r8d8/uaefi/boards/uaefi-f3/frame/efi-schematic.pdf

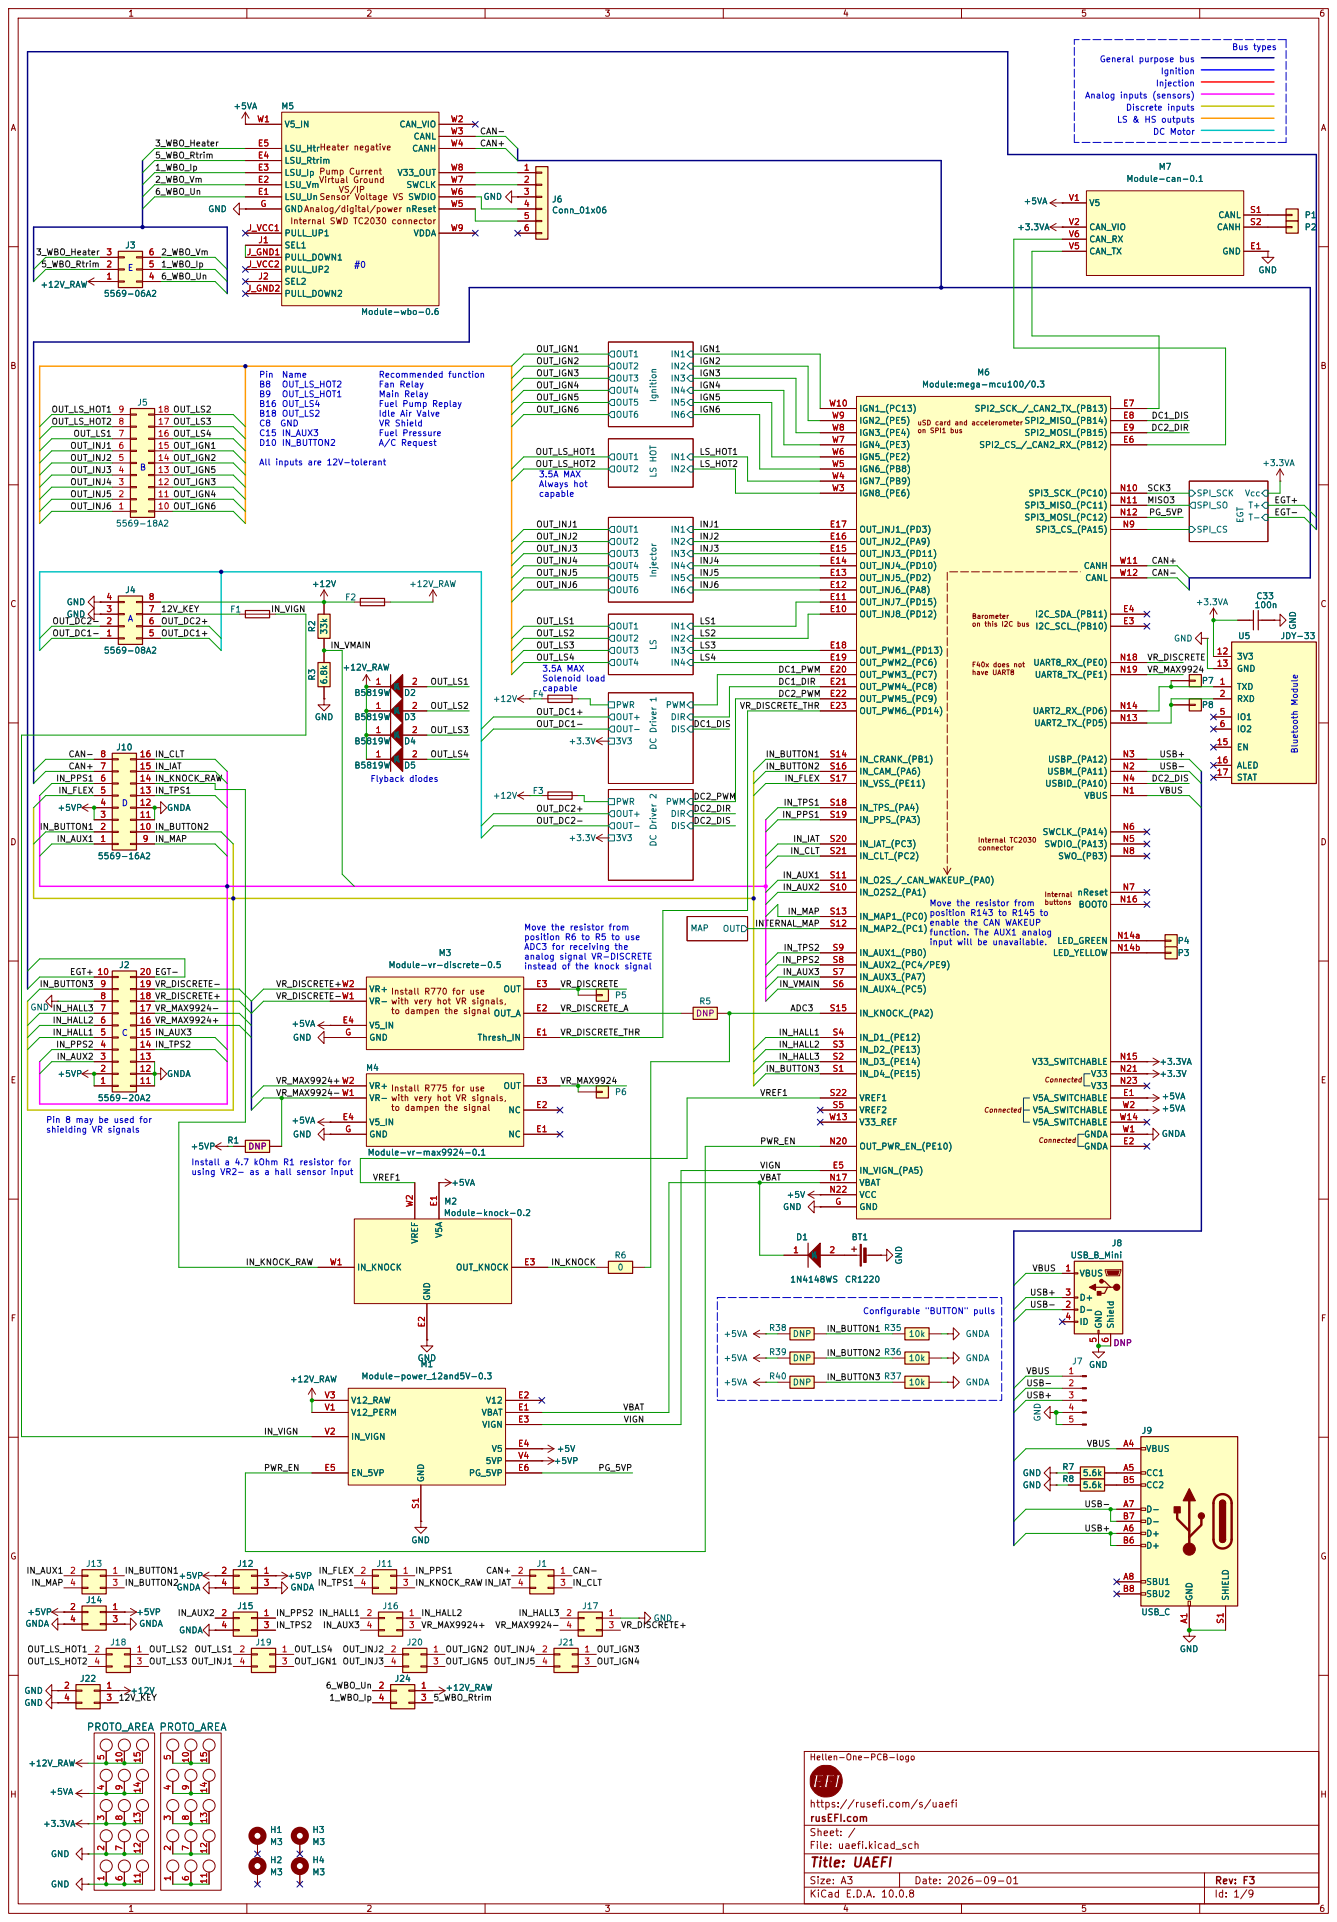
[picture p3: page 1]

Injection General purpose bus

Analog inputs (sensors) LS & HS outputs Discrete inputs

Internal SWD TC2030 connector Sensor Voltage VS Heater negative

Analog/digital/power Virtual Ground

OUT_INJ1
OUT_INJ2 OUT_INJ6
Always hot capable Pin 8 may be used for shielding VR signals

Move the resistor from
position R143 to R145 to
enable the CAN WAKEUP
function. The AUX1 analog

position R6 to R5 to use ADC3 for receiving the analog signal VR-DISCRETE

instead of the knock signal

Install R770 for use with very hot VR signals,

Install R775 for use with very hot VR signals,

Install a 4.7 kOhm R1 resistor for using VR2- as a hall sensor input

Hellen-One-PCB-logo

https://rusefi.com/s/uaefi
rusEFI.com
Sheet: /
File: uaefi.kicad_sch
Title: UAEFI

Size: A3 | Rev: F3
KiCad E.D.A. 10.0.8 | Id: 1/9

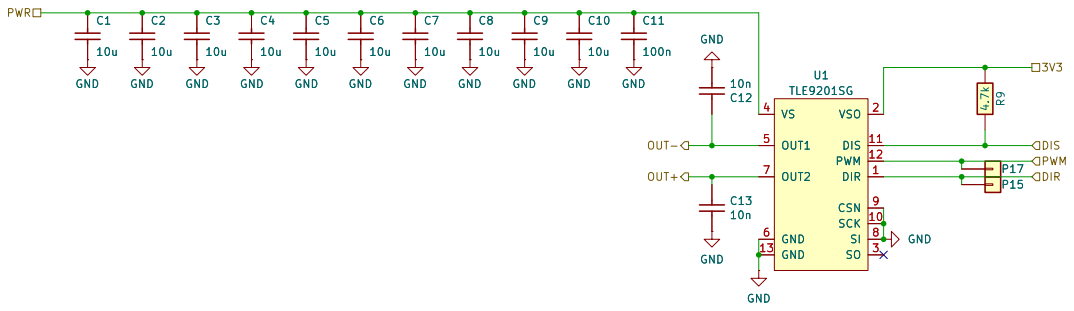
[picture p4: page 2]

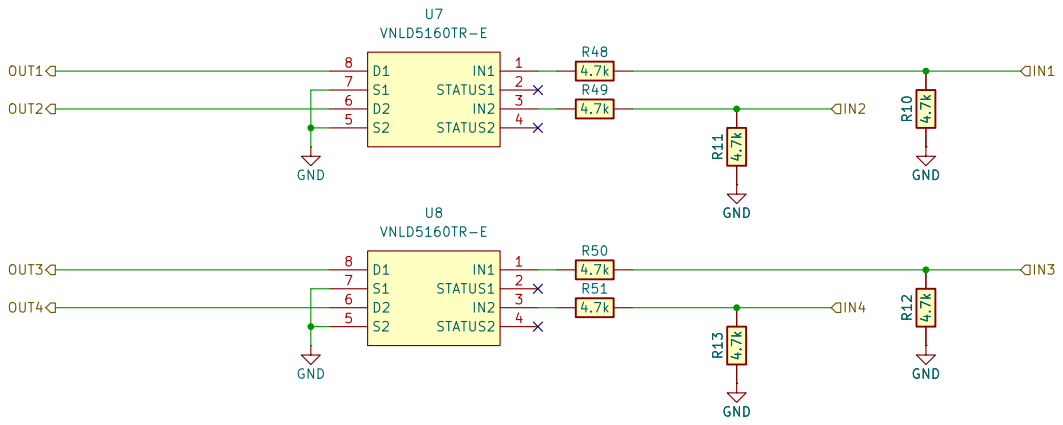
[picture p5: page 3]

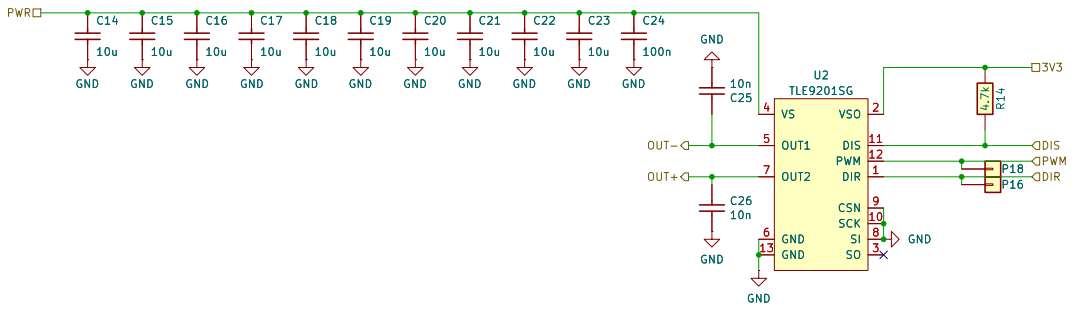
[picture p6: page 4]

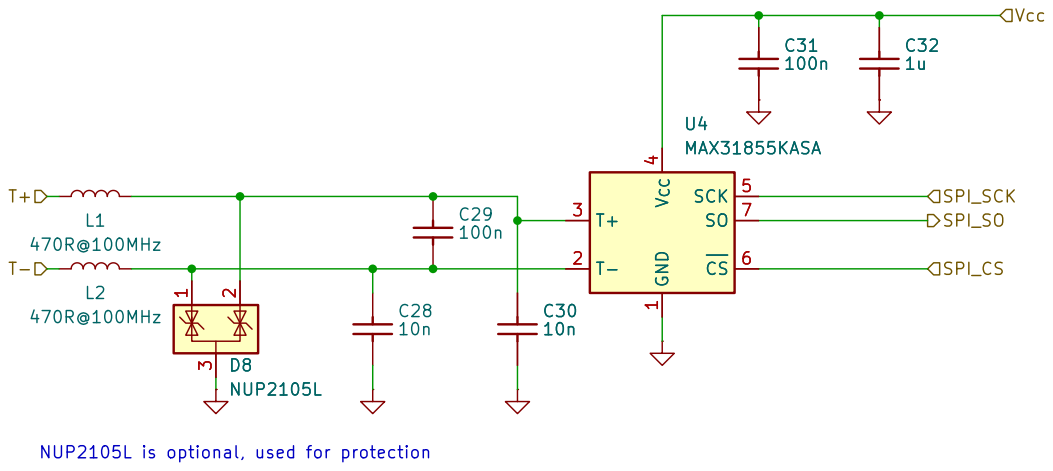
[picture p7: page 5]

NUP2105L is optional, used for protection D8NUP2105L 3

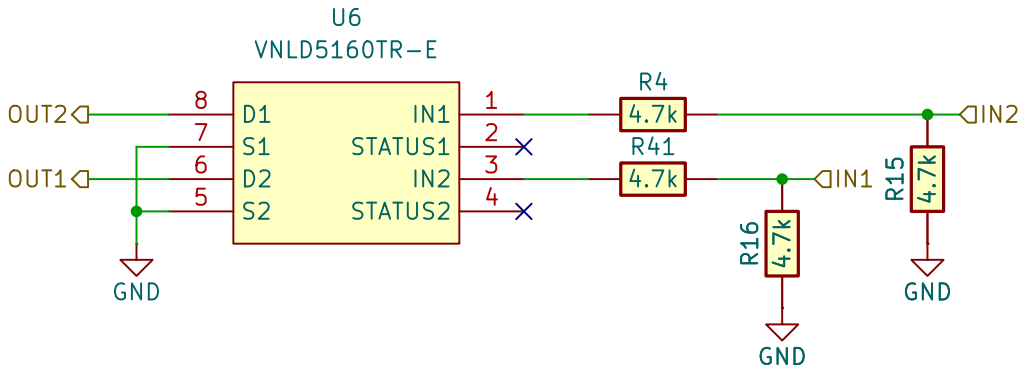
[picture p8: page 6]

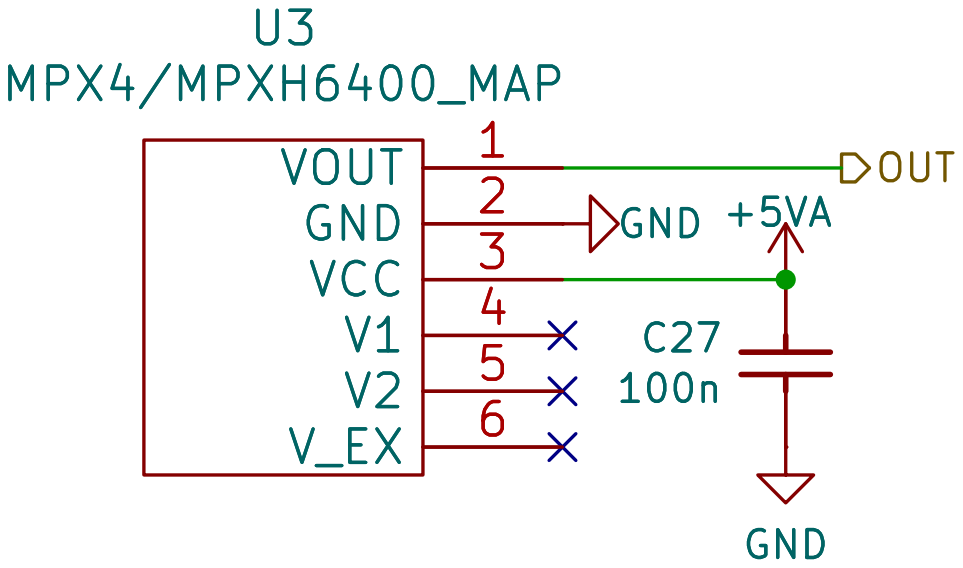
[picture p9: page 7]

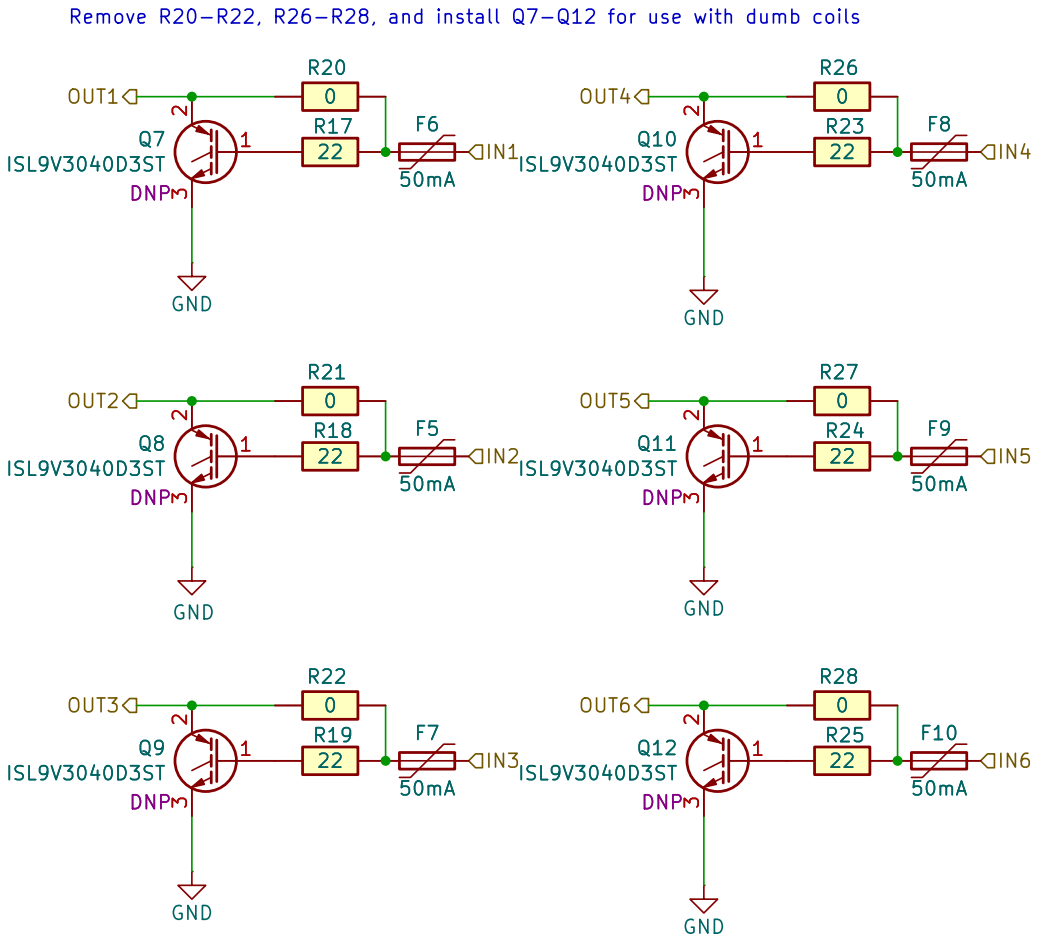
[picture p10: page 8]

IN1 Remove R20-R22, R26-R28, and install Q7-Q12 for use with dumb coils R21

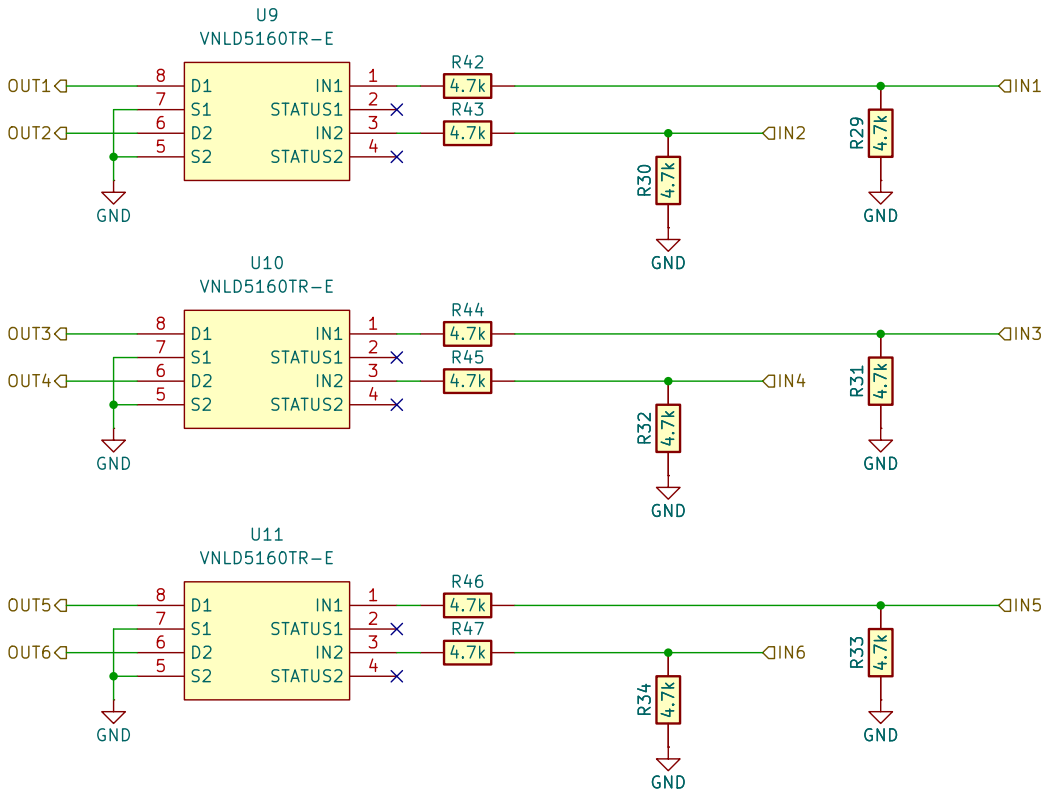
[picture p11: page 9]
