r8d8/uaefi/boards/uaefi-f3/board/uaefi-f3-schematic.pdf

IN3 Ignition OUT3 OUT2 OUT1 | IN1
uSD card and accelerometer on SPI1 bus | Barometer on this I2C bus F40x does not have UART8


Injection General purpose bus

Analog inputs (sensors) LS & HS outputs Discrete inputs

Internal SWD TC2030 connector Sensor Voltage VS Heater negative

Analog/digital/power Virtual Ground

OUT_INJ1
OUT_INJ2 OUT_INJ6
Always hot capable Pin 8 may be used for shielding VR signals

Move the resistor from
position R143 to R145 to
enable the CAN WAKEUP
function. The AUX1 analog

position R6 to R5 to use ADC3 for receiving the analog signal VR-DISCRETE

instead of the knock signal

Install R770 for use with very hot VR signals,

Install R775 for use with very hot VR signals,

Install a 4.7 kOhm R1 resistor for using VR2- as a hall sensor input

Hellen-One-PCB-logo

https://rusefi.com/s/uaefi
rusEFI.com
Sheet: /
File: uaefi.kicad_sch
Title: UAEFI
KiCad E.D.A. 10.0.8


SCK 10 DIS 11 PWM 12 GND 13 GND



SCK 10 DIS 11 PWM 12 GND 13 GND

D Date: 2026-07-14; KiCad E.D.A. 10.0.8; Size: A4; Rev: F3; Title: UAEFI; File: egt.kicad_sch; Sheet: /EGT/; VCC 4; SCK 5 CS 6; SO 7 U4MAX31855KASA; 470R@100MHz; 2 D8NUP2105L C28; SPI_CS; SPI_SCK; 2 U4MAX31855KASA GND

Vcc SPI_SO
rusEFI.com GND

NUP2105L is optional, used for protection D8NUP2105L ³

D Date: 2026-07-14; Size: A4; Rev: F3; GND R15 4.7k GND GND R16 4.7k; IN1 1 STATUS1 2 IN2 3 STATUS2 4; VNLD5160TR-E; IN2 OUT1; IN1 OUT2; R16 4.7k GND; GND R15 4.7k

rusEFI.com
Sheet: /LS HOT/
File: LS_HOT.kicad_sch
Title: UAEFI
KiCad E.D.A. 10.0.8

D Date: 2026-07-14; KiCad E.D.A. 10.0.8; Size: A4; Rev: F3; Title: UAEFI; File: MAP.kicad_sch; Sheet: /MAP/; rusEFI.com; VOUT; GND; VCC; U3 MPX4/MPXH6400_MAP; GND +5VA C27; OUT U3; MPX4/MPXH6400_MAP


IN1 Remove R20-R22, R26-R28, and install Q7-Q12 for use with dumb coils R21



Hellen One : Power-Module interface

Reverse polarity and overvoltage protection
F410 V12_RAW


# 6 U751 GND

1u R761


Id: 1/1 Title: File: hellen1-vr-discrete.kicad_sch Sheet: /


File: hellen1-vr-max9924.kicad_sch Sheet: /
Id: 1/1 Title: VR MAX9924 module

33n R604

# 100n GND

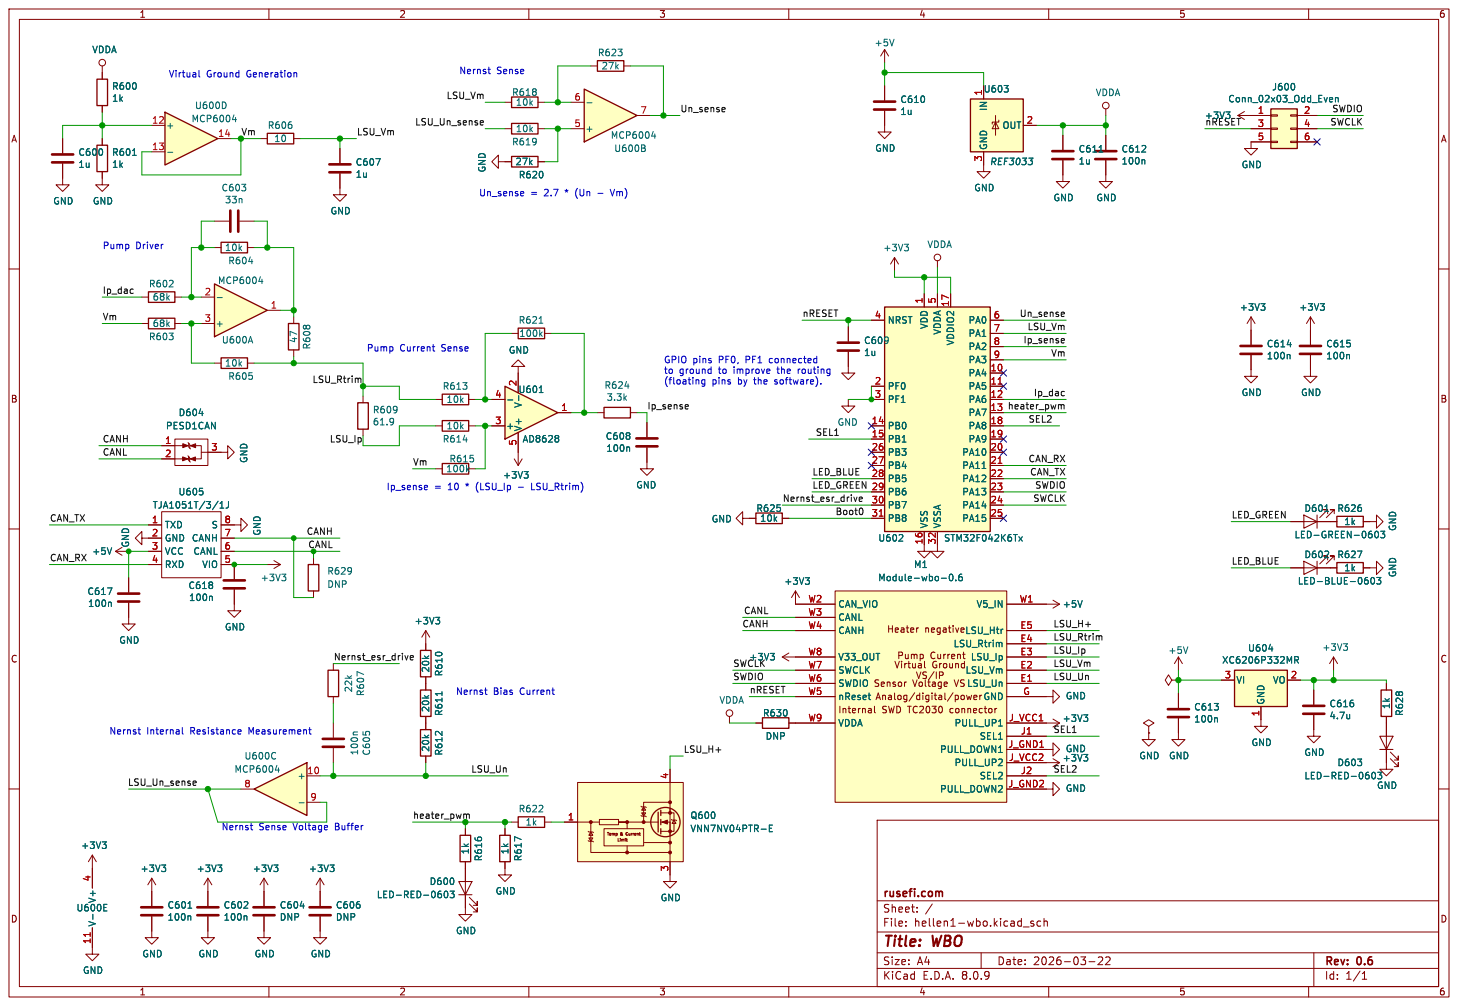
[picture p16: page 14]

1 PA4 10 PA5 11 PA6 12 PA7 13 PB0 14 PB1 15 VSS 16 VDDIO2 17 PA8 18 PA9 19 PF0 2 PA10 20 PA11 21 PA12 22 PA13 23 PA14 24 PA15 25 PB3 26 PB4 27 PB5 28 PB6 29 PF1 3 PB7 30 PB8 31 VSSA 32 NRST 4 VDDA

to ground to improve the routing

File: hellen1-wbo.kicad_sch Sheet: / rusefi.com

Vdd 4; Vss 6; MCP6004; GNDA; OUT1; OUT2; OUT3; OUT4

Vdd 4; Vss 6; MCP6004; GNDA; OUT1; OUT2; OUT3; OUT4

Vdd 4; Vss 6; MCP6004; GNDA; OUT1; OUT2; OUT3; OUT4; C190 PIC19001 100n; PIC19002 COC3; PIR19001; PIR19002; PIR19003; PIR19004; PIR19005; PIR19006; PIR19007; PIR19008; COR5; PIR19101; PIR19102; PIR19103; PIR19105; PIR19104; PIR19106; PIR19107; PIR19108; COR6; PIU19001; PIU19002; PIU19003; PIU19004; PIU19005; PIU19006; PIU19007; PIU19008; PIU19009; PIU190010; PIU190011; PIU190012; PIU190013; PIU190014; COU2; PIC19001; POOUT2; POOUT1; POOUT3; POOUT4; POIN1; POIN3 PIU19005; PIU190010 POIN4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

SPI_; VCC; 5 SPI_SCK; 7 SPI_O; lex MicroSD; _MIS


R143 populated: analog input O2S
R145 populated: WAKEUP by CAN

*VIGN input is unprotected!
*A21 is duplicated for ADC and EINT


See pullups replacement file for actual values


# See pullups replacement file for actual values


0 PESD; VCC; 5 RXD; 6 CANH

VRE; _CRA; _CLT; IAT; _IAT; VIG; nRes; VBAT; SWCL; SPI2; _MIS; SPI3; I2C_SCL; SPI1; PWR_; GRE; u mcu.Sch; _IGN; 8.Sch; _can can.Sch; d.Sch; nRS; USB_; P USB_; USBI; A I2C_SCL UART8_RX UART8_TX UART2_RX UART2_TX; N VBAT; VCC; ACC_SC; ACC_; ACC_MIS; ACC_MO; BARO; sen; ors.Sc; LVC1; VBU; wer.Sch; USBID (PA; USBM (PA; USBP (PA; 8 SWDIO (PA13); N5 SWCLK (PA14); N6 nReset; _SCK (PC1; _MISO (PC1; _MOSI (PC1; I2C_SCL (PB1; 3 I2C_SDA (PB11); E4 UART2_TX (PD5); _SCK; _MISO (PB1; _MOSI (PB1; _PWM2 (PC6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

USBM USBP USBID VBUS

### COR2

Vdd 4; Vss 6; MCP6004; GNDA; IN1 (CRNK); OUT1; OUT2; OUT3; OUT4; C195 PIC19501 100n; PIC19502 COC2; PIR19502; PIR19501; PIR19601; PIR19602; PIR19603; PIR19604; PIR19605; PIR19606; PIR19607; PIR19608; COR3; PIR19701; PIR19702; PIR19703; PIR19705; PIR19704; PIR19706; PIR19707; PIR19708; COR4; PIU19501; PIU19502; PIU19503; PIU19504; PIU19505; PIU19506; PIU19507; PIU19508; PIU19509; PIU195010; PIU195011; PIU195012; PIU195013; PIU195014; COU1; PIC19501; POOUT1; POOUT2; POOUT3; POOUT4; POIN1 (CRNK)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

More accurate threshold for "raw" connection of VR sensors


RES 5; GND(1) 6; GND(2); 7 GND(3); 8 VDD; 9 VDD_IO; INT_2 11; INT_1 12; U106 LIS2DH12TR; VDD 10; INT DRDY; RES 3; Vdd IO 1; GND; LPS22HBTR; ACC_SCK ACC_CS ACC_MISO ACC_MOSI; BARO_SCL BARO_SDA

SCL/SPC 1
SDO/SA0 3
SDA/SDI/SDO 4

SCL/SPC 2
SDO/SA0 5

andreika; Size:; Author:; Date:; Revision:; Sheet; PESD1CAN; GND; CANH; CANL; TXD 1 GND 2 VCC 3; Vio; 5 RXD 4; 6 CANH; TJA1051T/3/1J; CANH CANL; CAN_TX; CAN_RX; CAN_VIO; CAN_VIO V2; S2 CANL; CAN_TX V5; CAN_RX V6; Module:can/0.1

Hellen-One CAN
Title:

rusEFI EMS
Hellen-One Platform
https://rusefi.com/s/hellen72
