r8d8/uaefi/(commit log)

2026-11-01 uaefi-f3 BOM: IGBTs on coil channels 1 and 2 for the DLE-60's dumb coils
    Q7 and Q8 fitted (ISL9V3040D3ST, LCSC C603080), R20 and R21 removed, as the note
    on the Ignition sheet says. BOM only: same schematic, same revision, so the
    board stays f3 and the board ID doesn't change. Channels 3 to 6 stay logic
    outputs; B10 (IGN6) carries the throttle servo pulse.
    [bom_replace_uaefi-f3.csv]
2026-11-01 [skip actions] Auto-generated board v2.1
    [uaefi-B_Cu.gbl, uaefi-B_Mask.gbs, uaefi-B_Paste.gbp, uaefi-B_Silkscreen.gbo, uaefi-Edge_Cuts.gm1, uaefi-F_Cu.gtl, uaefi-F_Mask.gts, uaefi-F_Paste.gtp]
2026-11-01 uaefi-f3 BOM: VNLD5160 on U6-U11, Q600 left for hand fitting
    JLC has none of the VNLD5090 (C222209), so U6-U11 go back to the VNLD5160TR-E the
    schematic is drawn with (C377942). It is enough for the DLE-60: one injector, the
    pump on a relay. VNN7NV04PTR-E (Q600, the wideband heater switch) is out of stock
    at JLC and LCSC, so it stays off the assembly BOM and is fitted by hand.
    [bom_replace_uaefi-f3.csv]
